e-Power-UFRGS/e-Power_KiCad_library/3D_models/g5nb-1a_12dc-1.step

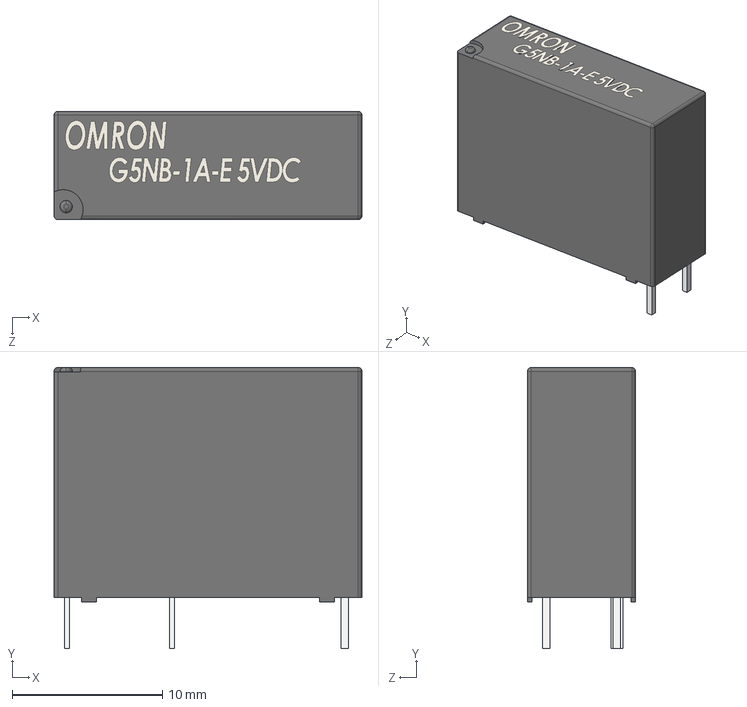
[picture p1: CAD file, 2020-10-14]
3D_models/g5nb-1a_12dc-1.step
20.5 x 18.7 x 7.20 mm
