e-Power-UFRGS/e-Power_KiCad_library/3D_models/smd-buttonm-8mm.step

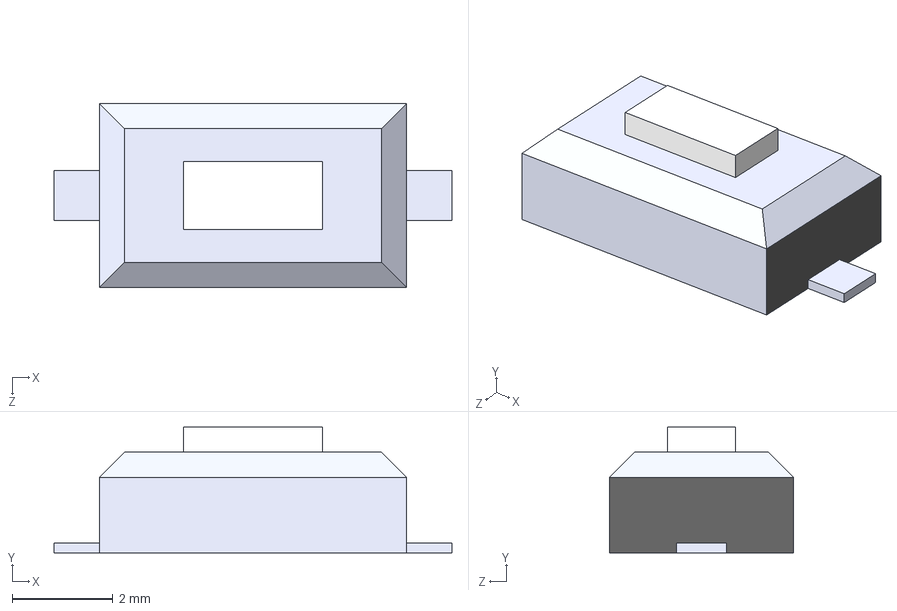
[picture p2: CAD file, 2020-09-07]
3D_models/smd-buttonm-8mm.step
7.90 x 2.50 x 3.65 mm
