e-Power-UFRGS/e-Power_KiCad_library/3D_models/molex_2x04_4.20mm.stp

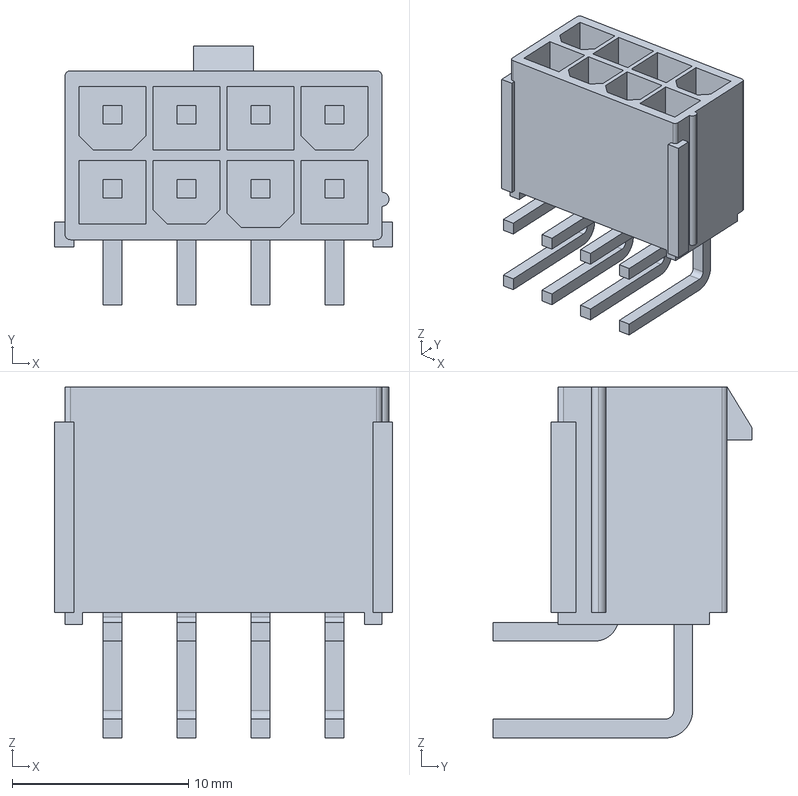
[picture p3: CAD file, 2020-08-24]
3D_models/molex_2x04_4.20mm.stp
19.2 x 14.7 x 19.9 mm
