e-Power-UFRGS/e-Power_KiCad_library/3D_models/power_inductor_12x12mm_height_8mm.step

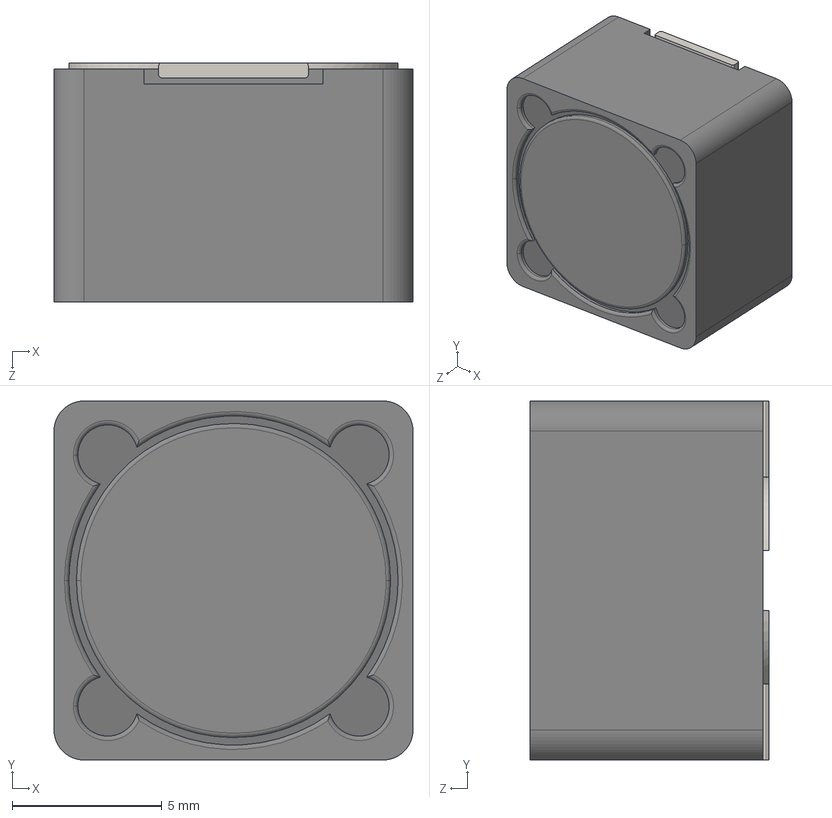
[picture p4: CAD file, 2020-08-13]
3D_models/power_inductor_12x12mm_height_8mm.step
12.0 x 12.0 x 8.00 mm
