e-Power-UFRGS/e-Power_KiCad_library/3D_models/MKDS-8-5.08.step

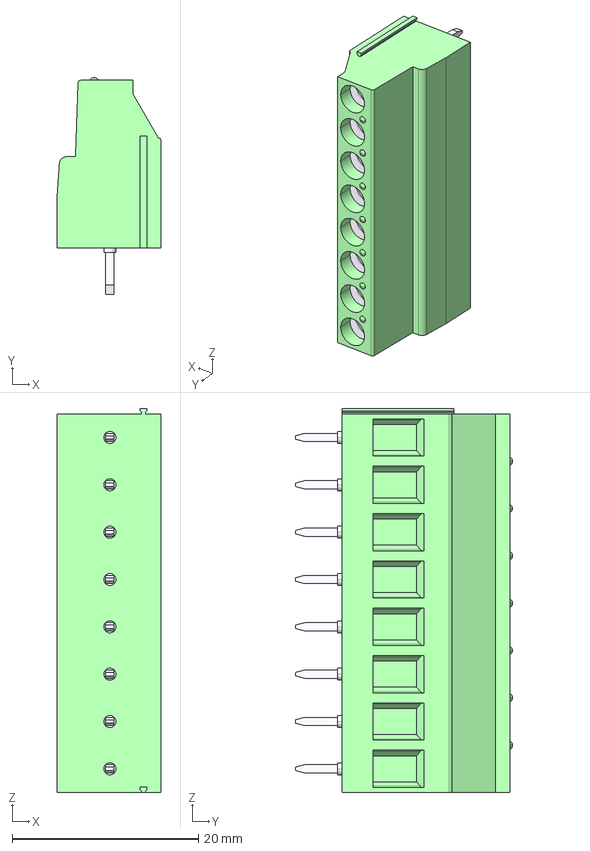
[picture p5: CAD file, 2020-07-13]
3D_models/MKDS-8-5.08.step
11.2 x 23.3 x 41.2 mm
