e-Power-UFRGS/e-Power_KiCad_library/3D_models/TO-92W.step

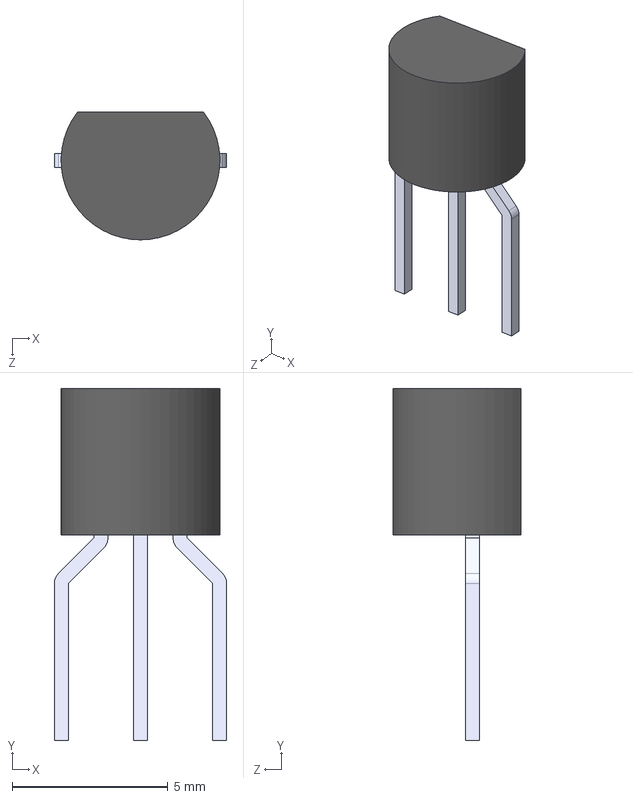
[picture p6: CAD file, 2020-07-13]
3D_models/TO-92W.step
5.53 x 11.3 x 4.10 mm
