e-Power-UFRGS/e-Power_KiCad_library/3D_models/DIP-8-SMD.step

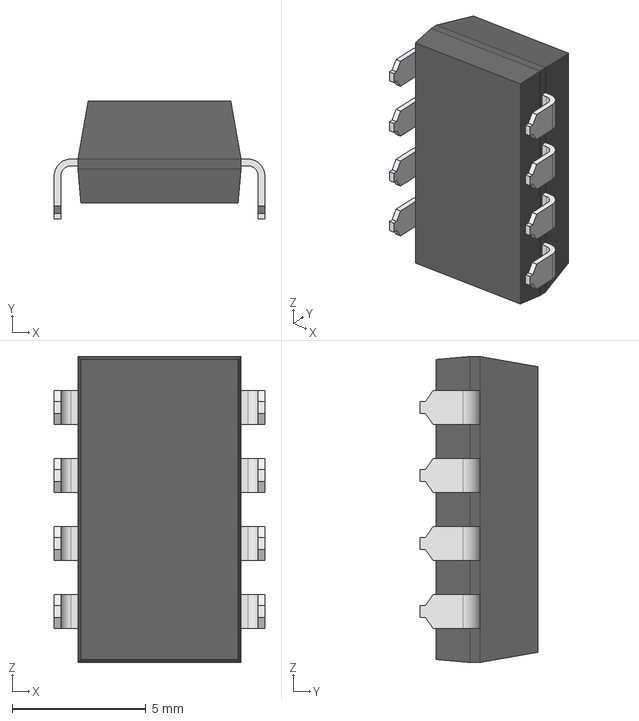
[picture p7: CAD file, 2020-07-13]
3D_models/DIP-8-SMD.step
7.87 x 4.39 x 11.4 mm
