e-Power-UFRGS/e-Power_KiCad_library/3D_models/TO-92-smd.step

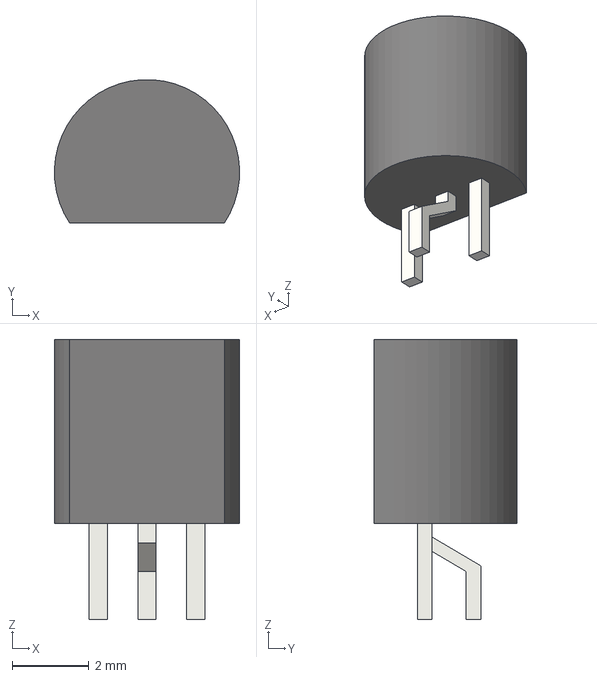
[picture p8: CAD file, 2020-07-13]
3D_models/TO-92-smd.step
4.83 x 3.74 x 7.30 mm
