e-Power-UFRGS/e-Power_KiCad_library/3D_models/SPST-6mmTactileSwitch.step

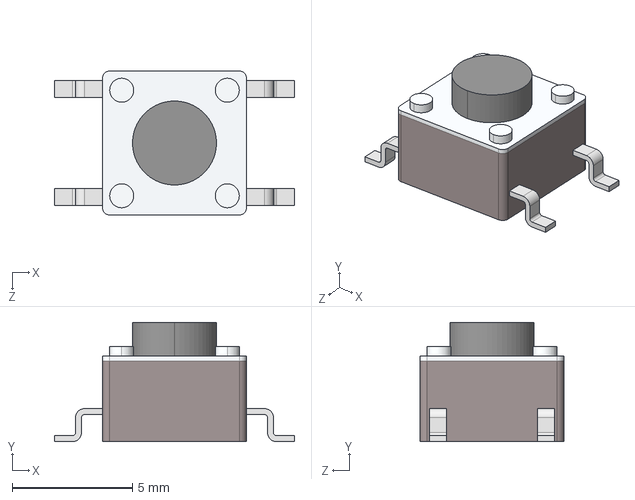
[picture p9: CAD file, 2020-07-13]
3D_models/SPST-6mmTactileSwitch.step
10.0 x 4.97 x 6.00 mm
