e-Power-UFRGS/e-Power_KiCad_library/3D_models/TO-220-3_Horizontal_SMD.step

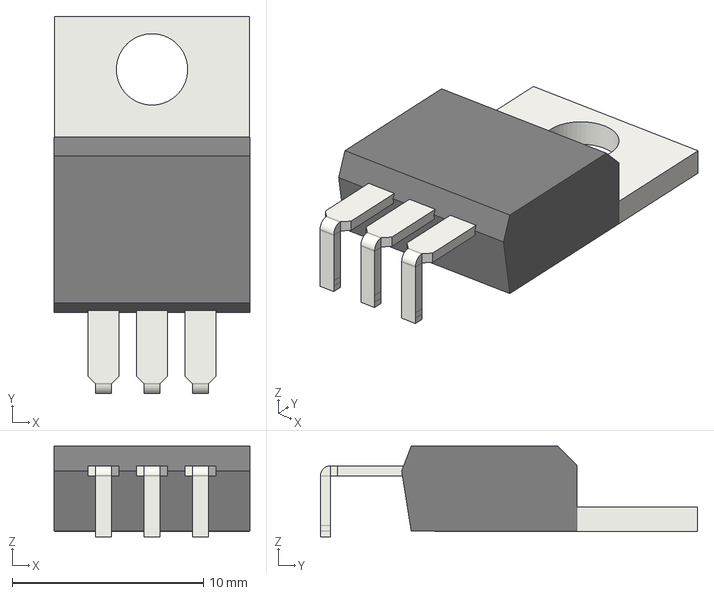
[picture p10: CAD file, 2020-07-13]
3D_models/TO-220-3_Horizontal_SMD.step
10.2 x 19.7 x 4.75 mm
