e-Power-UFRGS/e-Power_KiCad_library/3D_models/FUSE_1206.step

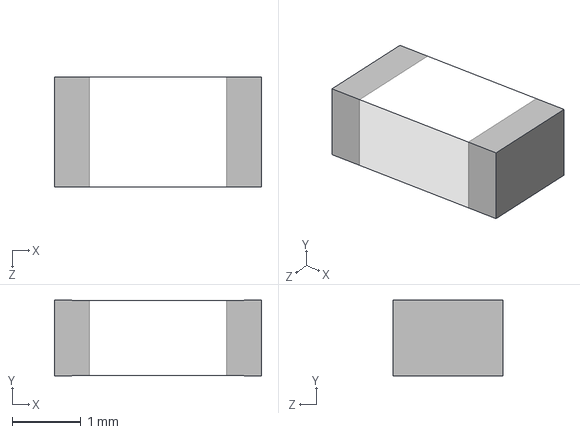
[picture p11: CAD file, 2020-07-13]
3D_models/FUSE_1206.step
3.02 x 1.10 x 1.60 mm
