e-Power-UFRGS/e-Power_KiCad_library/3D_models/cdrh104r.STEP

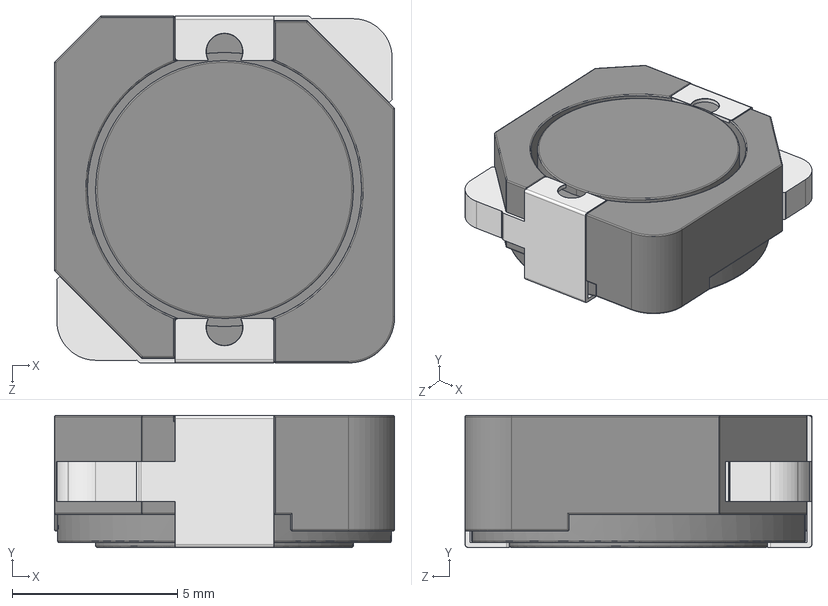
[picture p12: CAD file, 2020-07-13]
3D_models/cdrh104r.STEP
10.3 x 4.00 x 10.5 mm
CDRH104R_KORPUS
CDRH104R_NOGKA
CDRH104R_NOGKA_1
