e-Power-UFRGS/e-Power_KiCad_library/3D_models/DSUB-9 SMD.step

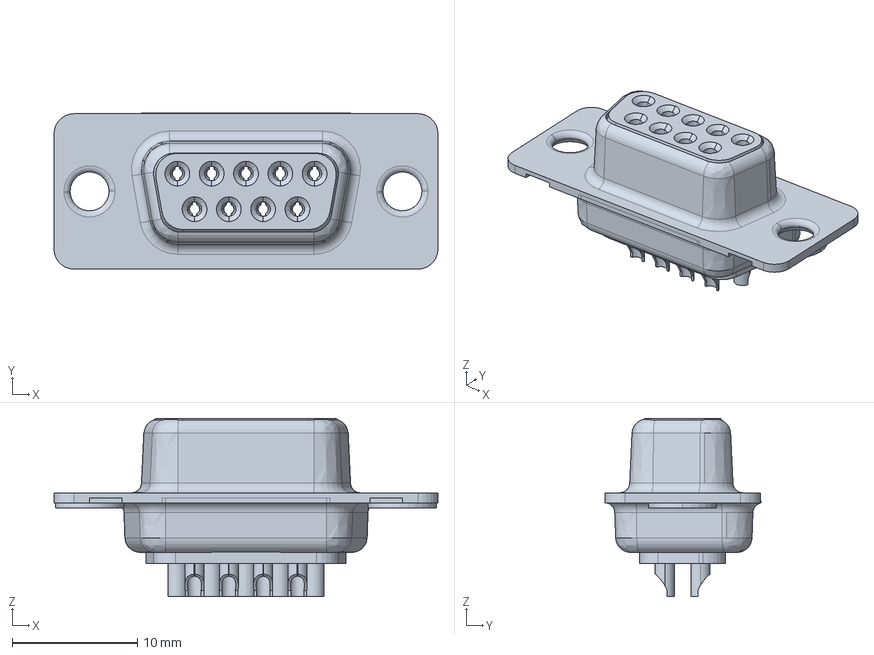
[picture p13: CAD file, 2020-07-13]
3D_models/DSUB-9 SMD.step
30.7 x 12.5 x 14.2 mm
