e-Power-UFRGS/e-Power_KiCad_library/3D_models/DIP-14-SOQUET-SMD.step

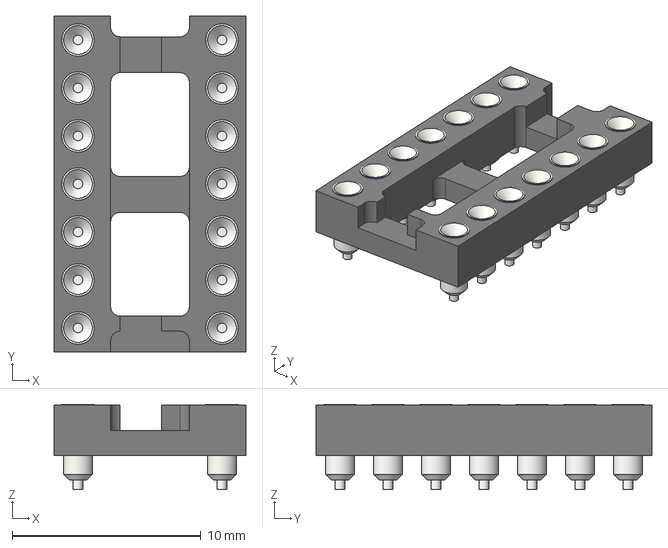
[picture p14: CAD file, 2020-07-13]
3D_models/DIP-14-SOQUET-SMD.step
10.2 x 17.8 x 4.51 mm
