e-Power-UFRGS/e-Power_KiCad_library/3D_models/SOIC-16.step

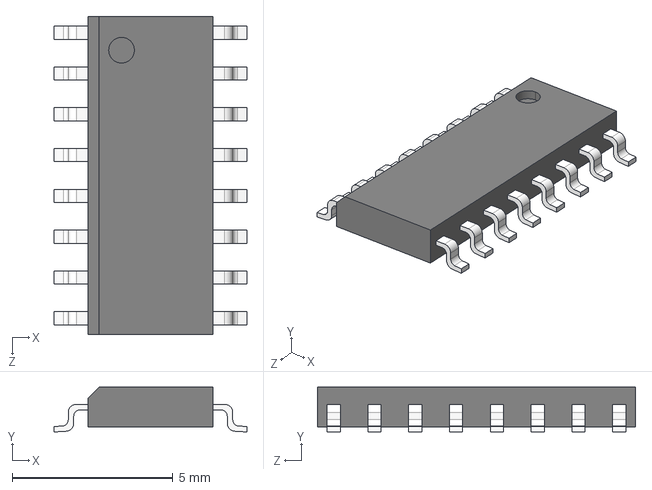
[picture p15: CAD file, 2020-07-13]
3D_models/SOIC-16.step
6.00 x 1.40 x 9.90 mm
