e-Power-UFRGS/e-Power_KiCad_library/3D_models/LED SMD0805.step

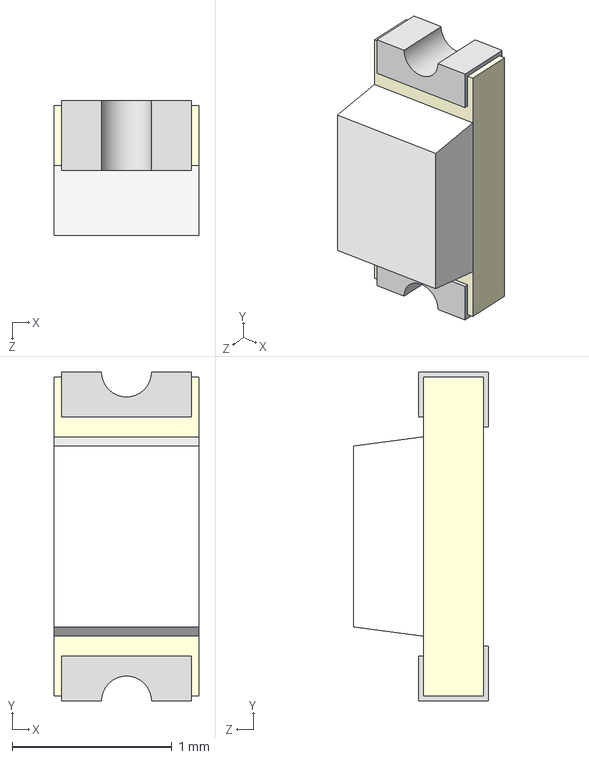
[picture p16: CAD file, 2020-07-13]
3D_models/LED SMD0805.step
0.906 x 2.06 x 0.844 mm
