e-Power-UFRGS/e-Power_KiCad_library/3D_models/DO-214AC.step

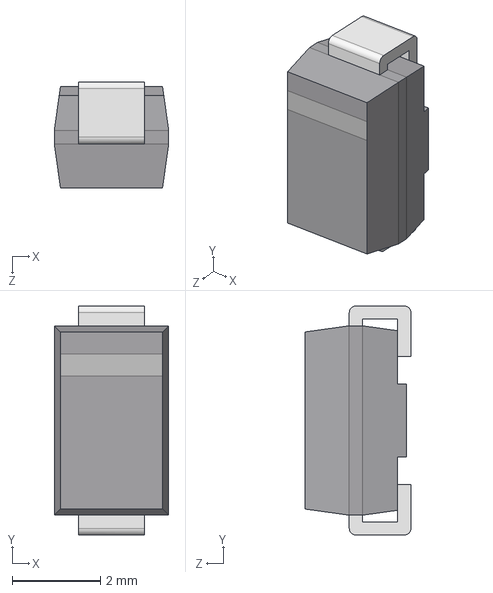
[picture p17: CAD file, 2020-07-13]
3D_models/DO-214AC.step
2.60 x 5.20 x 2.40 mm
