e-Power-UFRGS/e-Power_KiCad_library/3D_models/MKDS-4-5.08.step

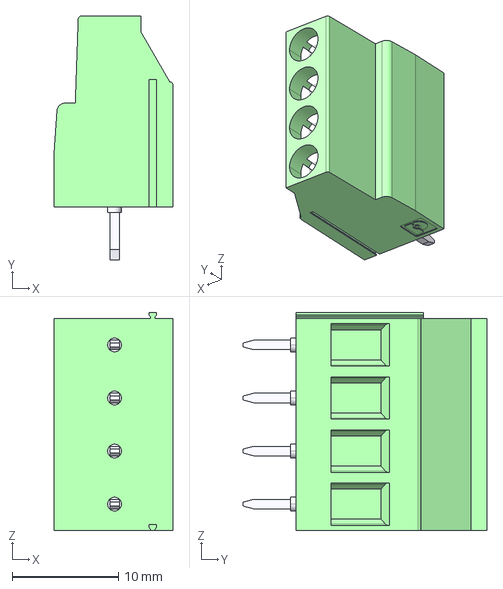
[picture p18: CAD file, 2020-07-13]
3D_models/MKDS-4-5.08.step
11.2 x 23.0 x 20.6 mm
