e-Power-UFRGS/e-Power_KiCad_library/3D_models/FB_0603.STEP

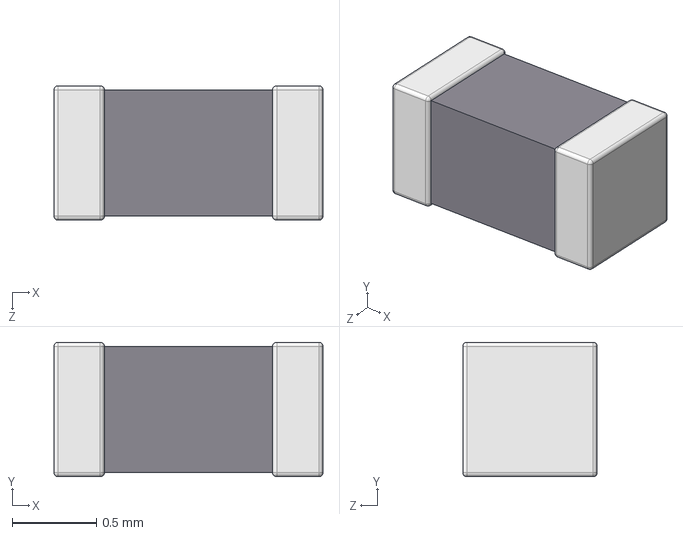
[picture p19: CAD file, 2020-07-13]
3D_models/FB_0603.STEP
1.60 x 0.8 x 0.8 mm
