e-Power-UFRGS/e-Power_KiCad_library/3D_models/ACS758ECB-200B-PFF-T.step

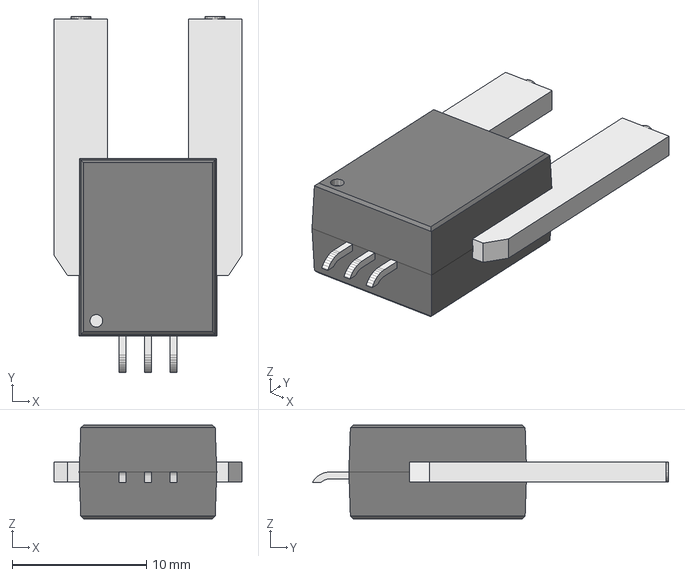
[picture p20: CAD file, 2020-07-13]
3D_models/ACS758ECB-200B-PFF-T.step
14.0 x 26.5 x 7.00 mm
