e-Power-UFRGS/e-Power_KiCad_library/3D_models/20mm_fuse.step

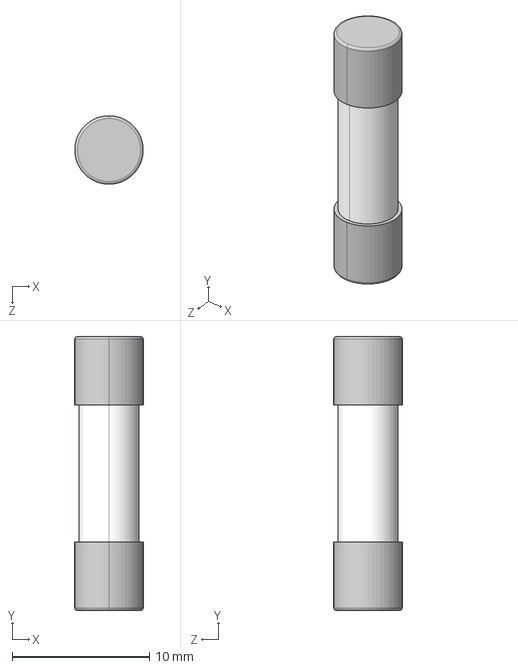
[picture p21: CAD file, 2020-07-13]
3D_models/20mm_fuse.step
5.00 x 20.0 x 5.00 mm
