e-Power-UFRGS/e-Power_KiCad_library/3D_models/SOP-16.STEP

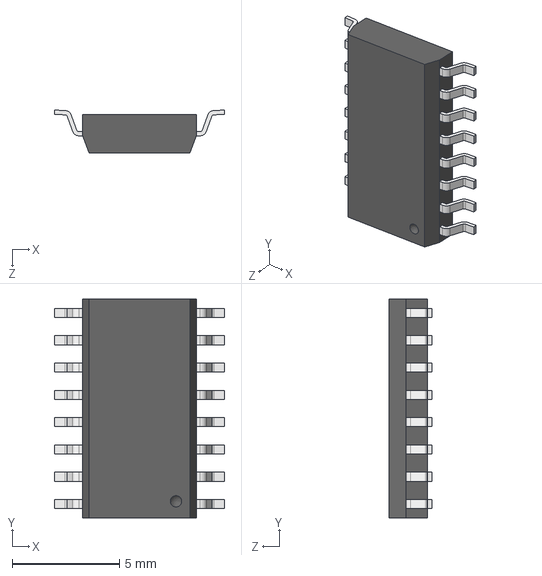
[picture p22: CAD file, 2020-07-13]
3D_models/SOP-16.STEP
7.92 x 10.2 x 2.00 mm
SOP16 Body
Foot SOP16 x 28
