e-Power-UFRGS/e-Power_KiCad_library/3D_models/DB9-female cable solder.step

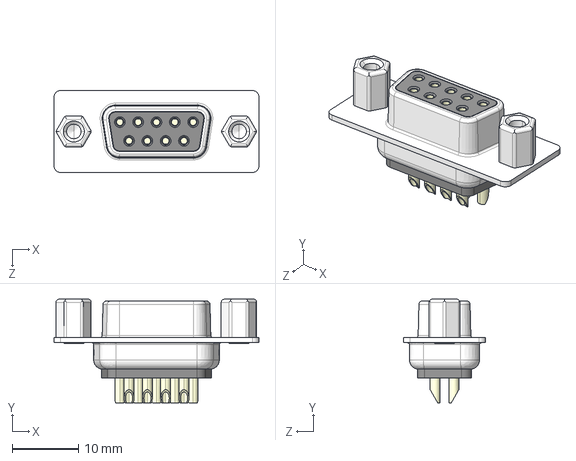
[picture p23: CAD file, 2020-07-13]
3D_models/DB9-female cable solder.step
31.0 x 15.7 x 12.4 mm
