e-Power-UFRGS/e-Power_KiCad_library/3D_models/TRIMPOT_10TURNS.step

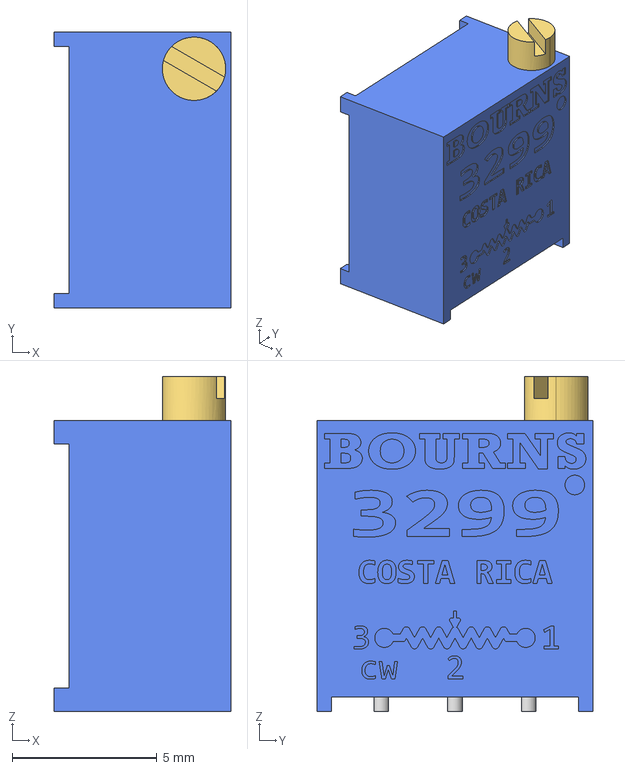
[picture p24: CAD file, 2020-07-13]
3D_models/TRIMPOT_10TURNS.step
6.10 x 9.53 x 11.6 mm
