e-Power-UFRGS/e-Power_KiCad_library/3D_models/micro_usb.stp

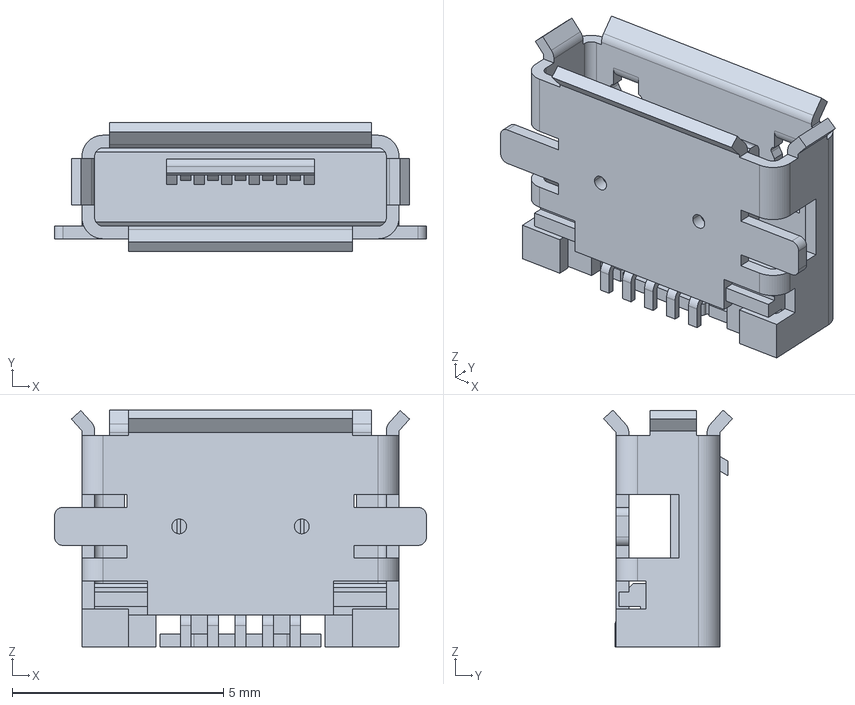
[picture p25: CAD file, 2020-07-13]
3D_models/micro_usb.stp
8.80 x 3.05 x 5.60 mm
