e-Power-UFRGS/e-Power_KiCad_library/3D_models/CircuitWorks-SO-16.step

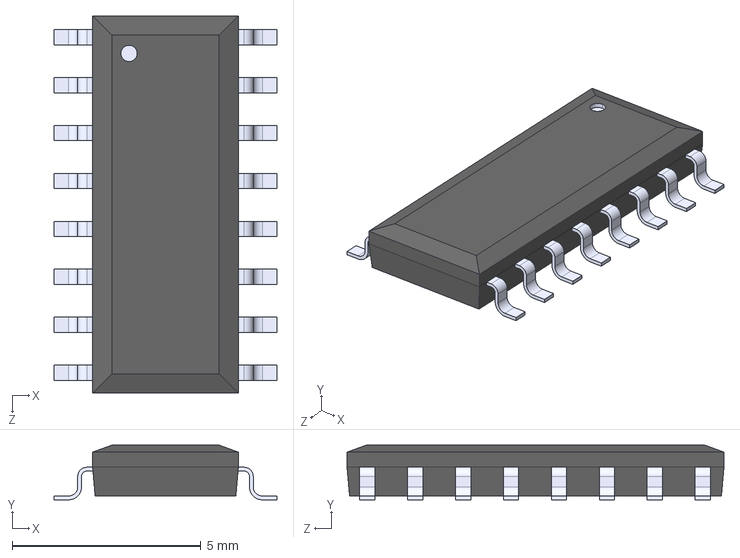
[picture p26: CAD file, 2020-07-13]
3D_models/CircuitWorks-SO-16.step
5.91 x 1.45 x 9.98 mm
