e-Power-UFRGS/e-Power_KiCad_library/3D_models/DO-35-40.step

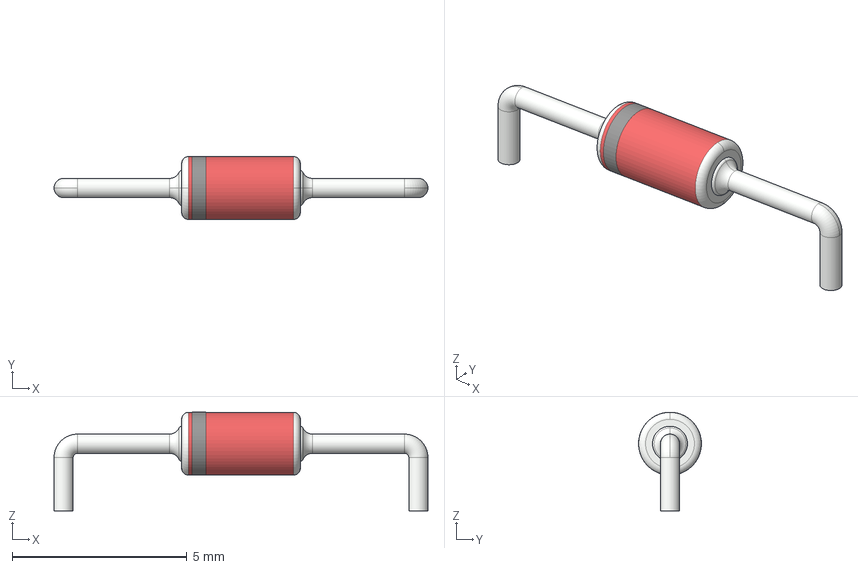
[picture p27: CAD file, 2020-07-13]
3D_models/DO-35-40.step
10.7 x 1.80 x 2.82 mm
