e-Power-UFRGS/e-Power_KiCad_library/3D_models/fuse smd-1.step

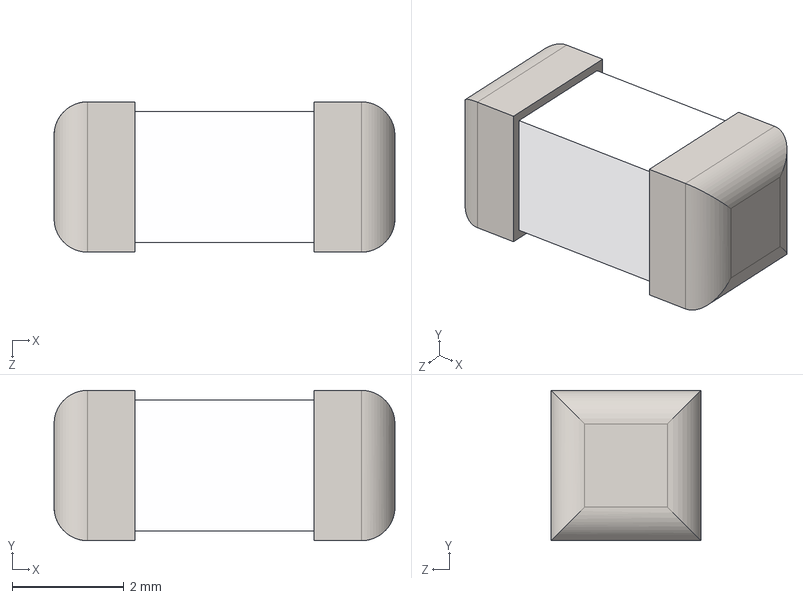
[picture p28: CAD file, 2020-07-13]
3D_models/fuse smd-1.step
6.10 x 2.69 x 2.69 mm
