e-Power-UFRGS/e-Power_KiCad_library/3D_models/DIP-16-SOQUET-SMD.step

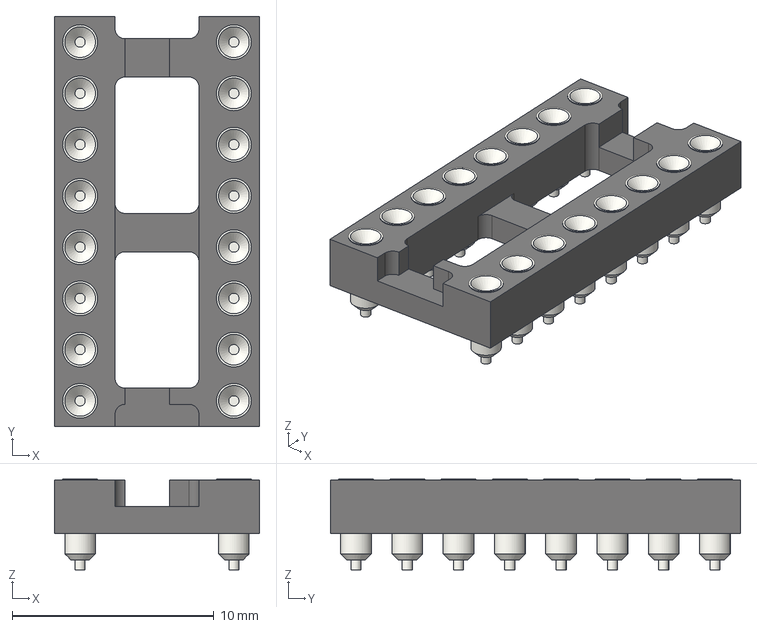
[picture p29: CAD file, 2020-07-13]
3D_models/DIP-16-SOQUET-SMD.step
10.2 x 20.3 x 4.51 mm
