e-Power-UFRGS/e-Power_KiCad_library/3D_models/MKDS-2-5.08.step

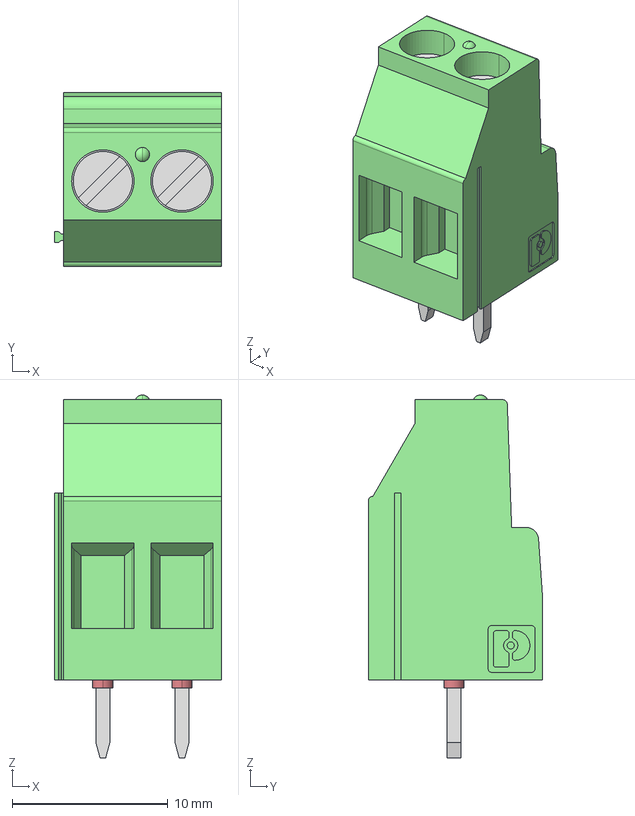
[picture p30: CAD file, 2020-07-13]
3D_models/MKDS-2-5.08.step
10.7 x 11.2 x 23.3 mm
