e-Power-UFRGS/e-Power_KiCad_library/3D_models/DO-41.STEP

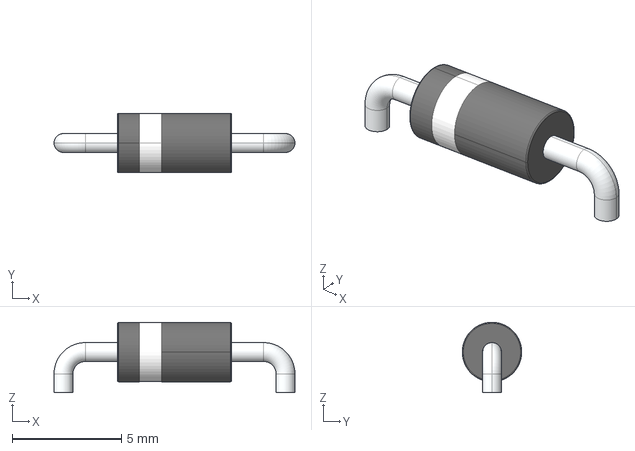
[picture p31: CAD file, 2020-07-13]
3D_models/DO-41.STEP
11.0 x 2.72 x 3.22 mm
