e-Power-UFRGS/e-Power_KiCad_library/3D_models/SOD-80.STEP

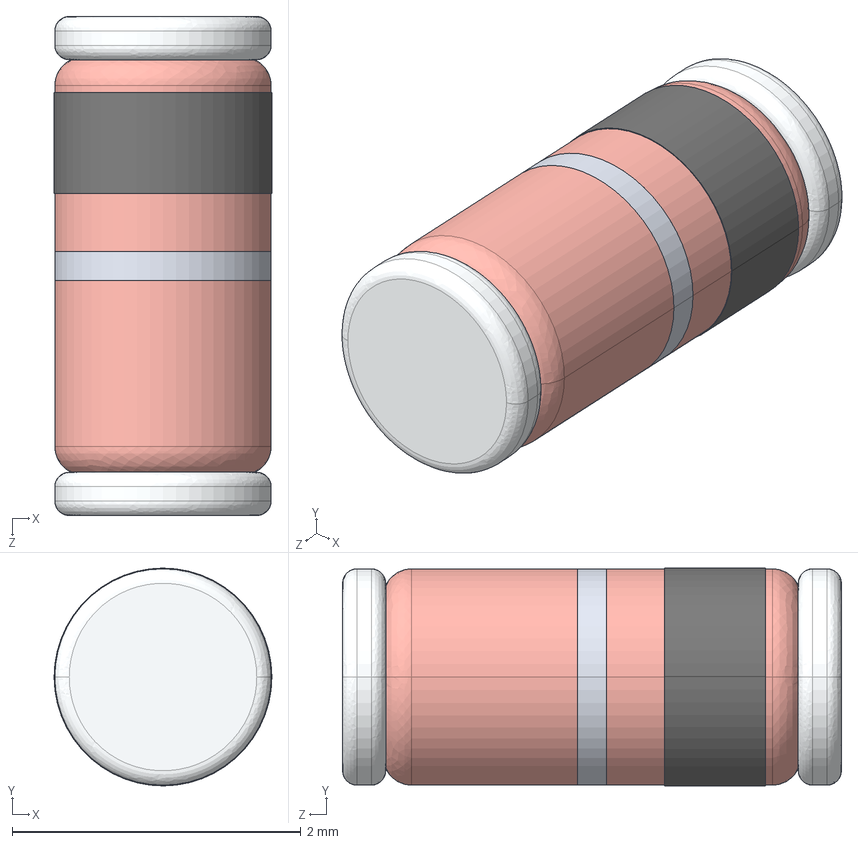
[picture p32: CAD file, 2020-07-13]
3D_models/SOD-80.STEP
1.51 x 1.51 x 3.46 mm
鳪錌擯膻嶱1 x 2
罻襜踆1
ïåðåõîä_1
懤噉_1 x 2
