e-Power-UFRGS/e-Power_KiCad_library/(list of files, cad)

Other CAD files:
3D_models/TRIMPOT_10TURNS(2).step
