e-Power-UFRGS/e-Power_KiCad_library/(commit log)

2020-06-24 Adicionar a biblioteca da e-Power
    pra ser usada na apresentação
2020-07-13 canges have been made
    [20mm_fuse.step, ACS758ECB-200B-PFF-T.step, CircuitWorks-SO-16.step, DB9-female cable solder.step, DIP-14-SOQUET-SMD.step, DIP-16-SOQUET-SMD.step, DIP-8-SMD.step, DO-214AC.step]
2020-07-13 alterei a descricao do LED SMD
2020-07-13 mudei o nome do led
2020-07-13 alterei de novo o nome do LED
2020-07-14 add silkcreen to logo e-Power_41.3x20.0mm_Copper.kicad_mod
2020-07-15 alterei o footprint do logo e-Power_22.8x12.0mm para conter o silkscreen tambem
2020-07-17 arrumei o modelo 3d do relay
2020-07-18 mudei o modelo 3d do indutor de potencia
2020-07-18 Atualizado 3d FUSE
2020-07-22 made some changes to the footprint logos and added mounting holes
2020-07-22 resolvi alguns problemas de merge
2020-07-28 add mouting hole 4mm
2020-08-03 updates made on fuse and zero_ohm_resistor footprint
2020-08-13 update logos
    [power_inductor_12x12mm_height_8mm.step]
2020-08-24 add molex connector to library
    [molex_2x04_4.20mm.stp]
2020-08-27 logos on solder mask
2020-09-07 update library
    [smd-buttonm-8mm.step]
2020-10-14 novos componentes
    [g5nb-1a_12dc-1.step]
